cedossth/hydroponic-aiot/docs/dashboard/grafana_essai.png

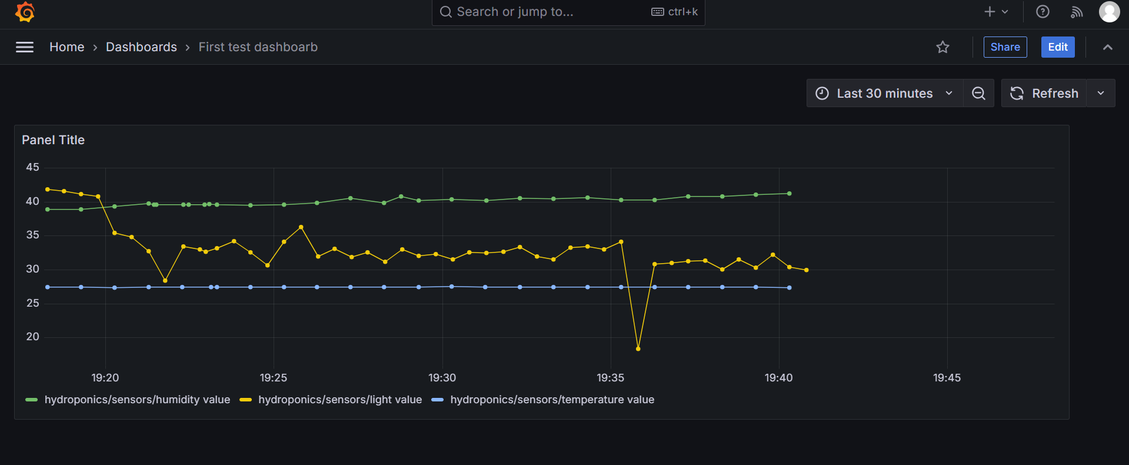
docs/dashboard/grafana_essai.png
