cedossth/hydroponic-aiot/(list of files, drawings)

Other design files:
hardware/Mon_montage_hydro_system_final.fzz
